Weistr/PV_Holder/Mechinery/chihai-chw-gw4632-370-dc-worm-gear-motor-6-v-6-rpm-2.snapshot.17/Chihai CHW-GW4632-370, DC Worm Gear Motor, 6 V, 6 RPM.JPG

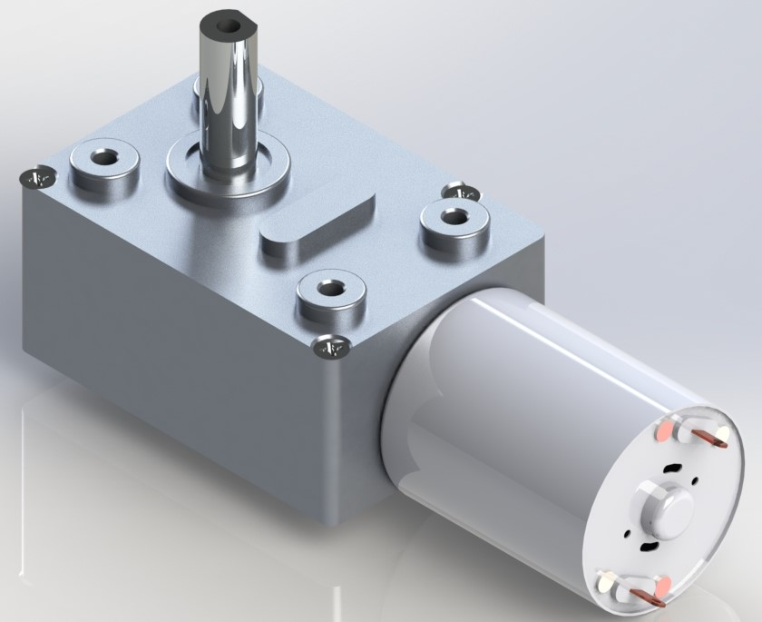
Mechinery/chihai-chw-gw4632-370-dc-worm-gear-motor-6-v-6-rpm-2.snapshot.17/Chihai CHW-GW4632-370, DC Worm Gear Motor, 6 V, 6 RPM.JPG
