Weistr/PV_Holder/Mechinery/chihai-chw-gw4632-370-dc-worm-gear-motor-6-v-6-rpm-2.snapshot.17/DC Motor, Chihai CHW-GW4632-370, DC Worm Gear Motor, 6 V, 6 RPM.SLDASM

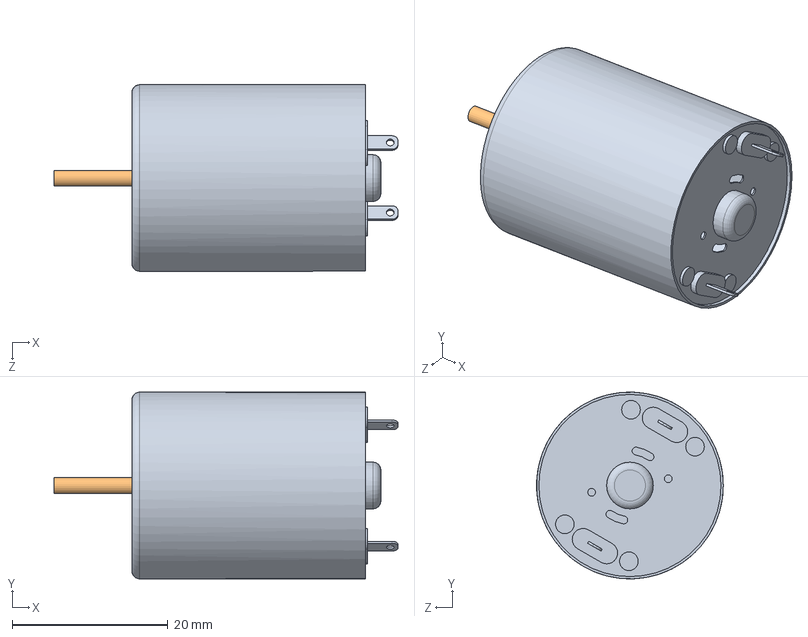
[picture p5: CAD file, 2024-04-27]
Mechinery/chihai-chw-gw4632-370-dc-worm-gear-motor-6-v-6-rpm-2.snapshot.17/DC Motor, Chihai CHW-GW4632-370, DC Worm Gear Motor, 6 V, 6 RPM.SLDASM
44.2 x 24.0 x 24.0 mm
DC Motor Body, Chihai CHW-GW4632-370, DC Worm Gear Motor, 6 V, 6 RPM
DC Motor Shaft, Chihai CHW-GW4632-370, DC Worm Gear Motor, 6 V, 6 RPM
