Weistr/PV_Holder/Mechinery/总装.SLDASM

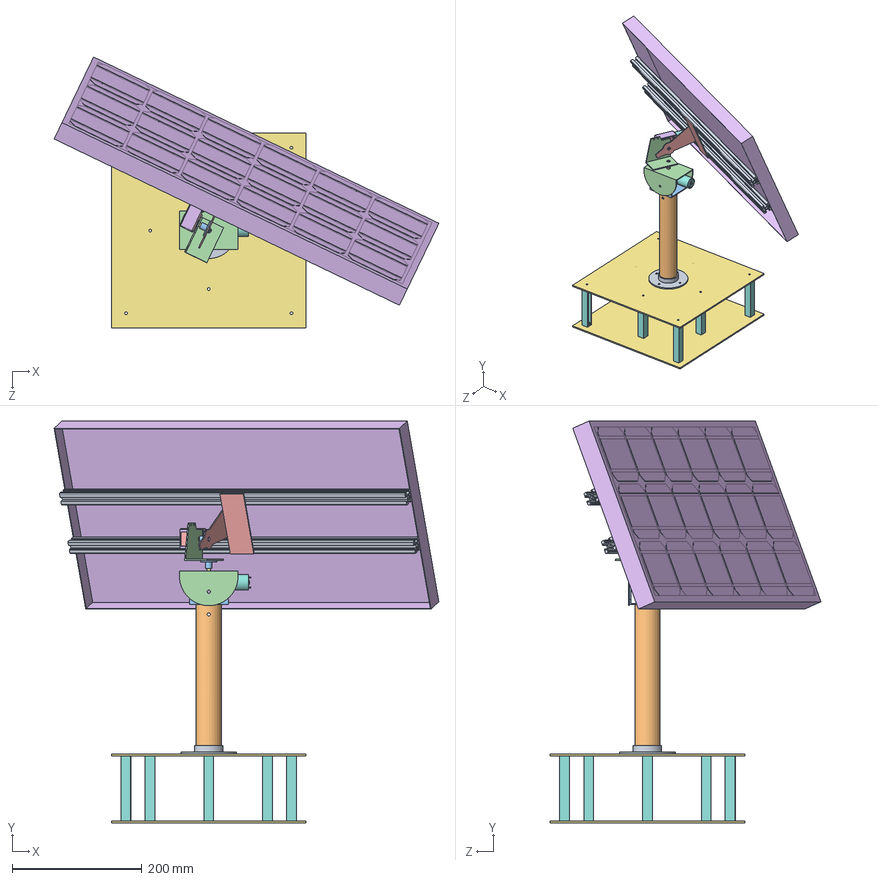
[picture p6: CAD file, 2024-05-19]
Mechinery/总装.SLDASM
592.3 x 618.8 x 417.2 mm
底座
连接柱
U连接1
U连接2
Cover, Chihai CHW-GW4632-370, DC Worm Gear Motor, 6 V, 6 RPM x 2
Gear Body, Chihai CHW-GW4632-370, DC Worm Gear Motor, 6 V, 6 RPM x 2
Shaft, Chihai CHW-GW4632-370, DC Worm Gear Motor, 6 V, 6 RPM x 2
DC Motor Body, Chihai CHW-GW4632-370, DC Worm Gear Motor, 6 V, 6 RPM x 2
DC Motor Shaft, Chihai CHW-GW4632-370, DC Worm Gear Motor, 6 V, 6 RPM x 2
M2 X 6 SS Flat Head Screw, Chihai CHW-GW4632-370, DC Worm Gear Motor, 6 V, 6 RPM x 8
电机联轴 x 2
L连接1
L连接2
Solar PV Panel
底座亚克力板1 x 2
底座支柱2 x 8
铝型材2020R1.5_p1 x 2
