Weistr/PV_Holder/Mechinery/太阳能板/Solar PV Panel.SLDPRT

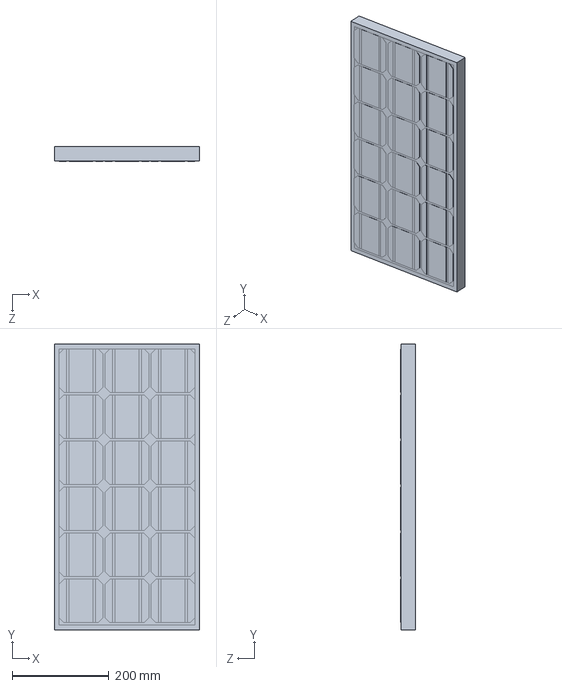
[picture p8: CAD file, 2024-04-27]
Mechinery/太阳能板/Solar PV Panel.SLDPRT
300.0 x 590.0 x 30.5 mm
