Weistr/PV_Holder/Mechinery/总装 - 底座-1.STL

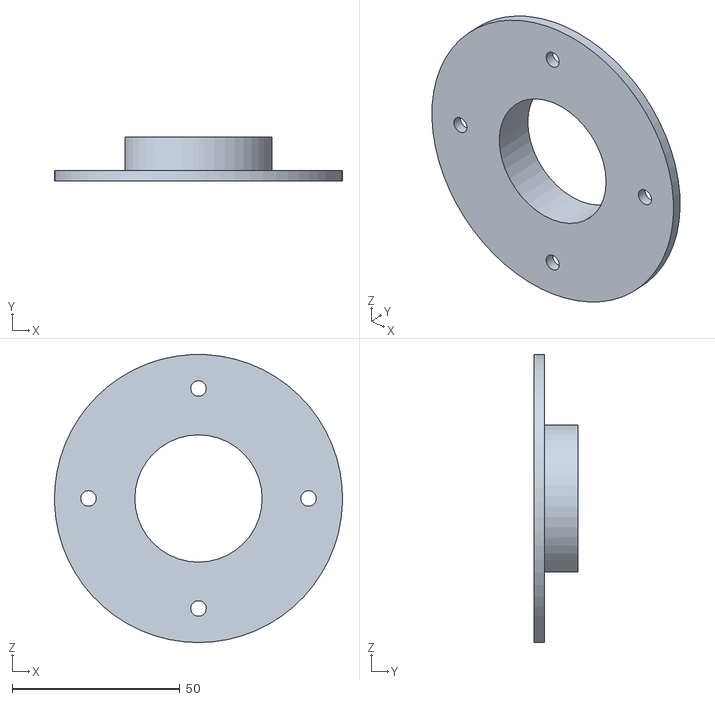
[picture p9: CAD file, 2024-05-19]
Mechinery/总装 - 底座-1.STL
86.0 x 13.0 x 86.0
