Weistr/PV_Holder/Mechinery/chihai-chw-gw4632-370-dc-worm-gear-motor-6-v-6-rpm-2.snapshot.17/Shaft, Chihai CHW-GW4632-370, DC Worm Gear Motor, 6 V, 6 RPM.SLDPRT

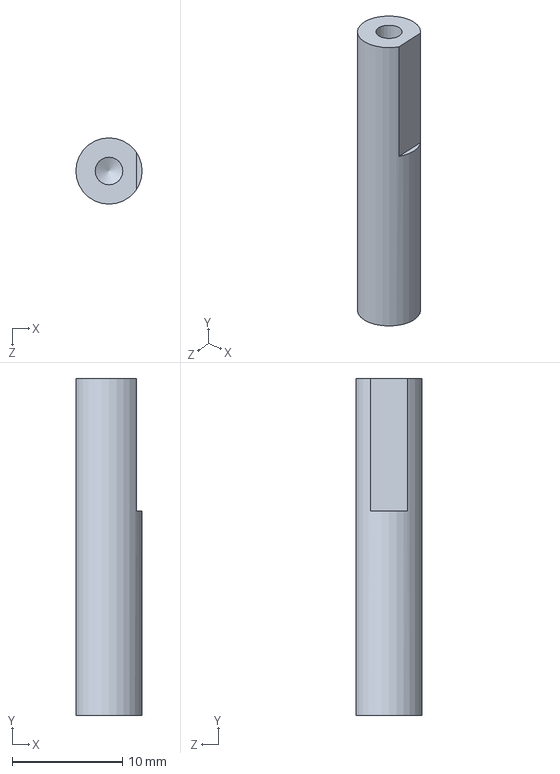
[picture p10: CAD file, 2024-04-27]
Mechinery/chihai-chw-gw4632-370-dc-worm-gear-motor-6-v-6-rpm-2.snapshot.17/Shaft, Chihai CHW-GW4632-370, DC Worm Gear Motor, 6 V, 6 RPM.SLDPRT
6.00 x 30.5 x 6.00 mm
