Weistr/PV_Holder/Mechinery/make/总装.STEP

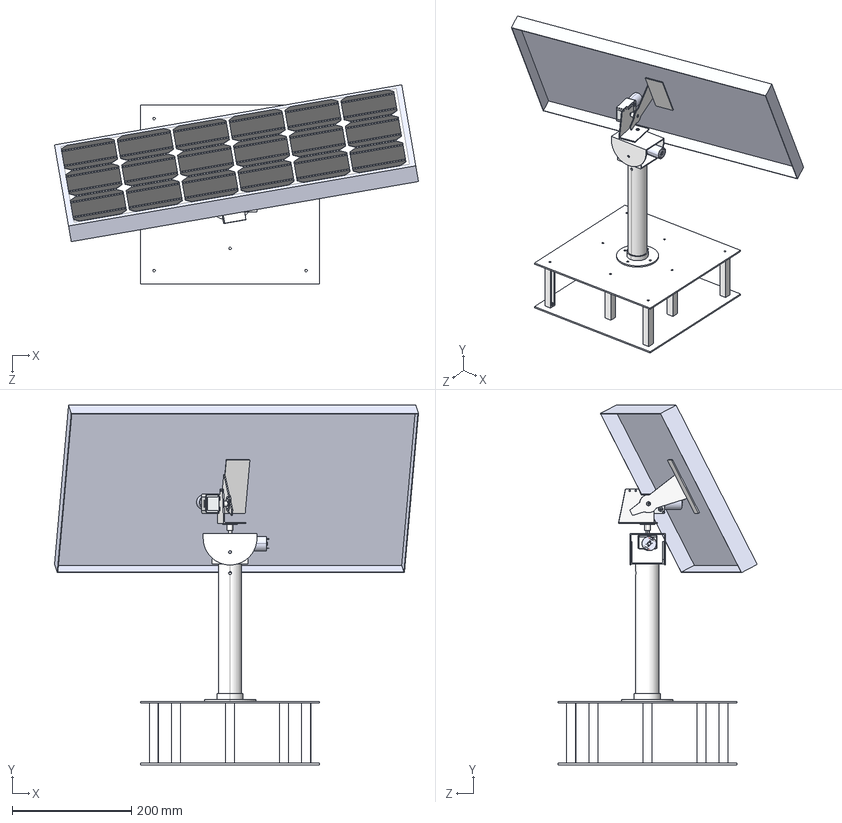
[picture p11: CAD file, 2024-05-19]
Mechinery/make/总装.STEP
609.4 x 601.9 x 333.9 mm
菁釱
蟀諉翐
U蟀諉1
U蟀諉2
Cover, Chihai CHW-GW4632-370, DC Worm Gear Motor, 6 V, 6 RPM x 2
Gear Body, Chihai CHW-GW4632-370, DC Worm Gear Motor, 6 V, 6 RPM x 2
Shaft, Chihai CHW-GW4632-370, DC Worm Gear Motor, 6 V, 6 RPM x 2
DC Motor Body, Chihai CHW-GW4632-370, DC Worm Gear Motor, 6 V, 6 RPM x 2
DC Motor Shaft, Chihai CHW-GW4632-370, DC Worm Gear Motor, 6 V, 6 RPM x 2
M2 X 6 SS Flat Head Screw, Chihai CHW-GW4632-370, DC Worm Gear Motor, 6 V, 6 RPM_default x 8
电机联轴 x 2
L蟀諉1
L蟀諉2
Solar PV Panel
底座亚克力板1 x 2
底座支柱2 x 8
