Weistr/PV_Holder/Mechinery/总装 - 连接柱-1.STL

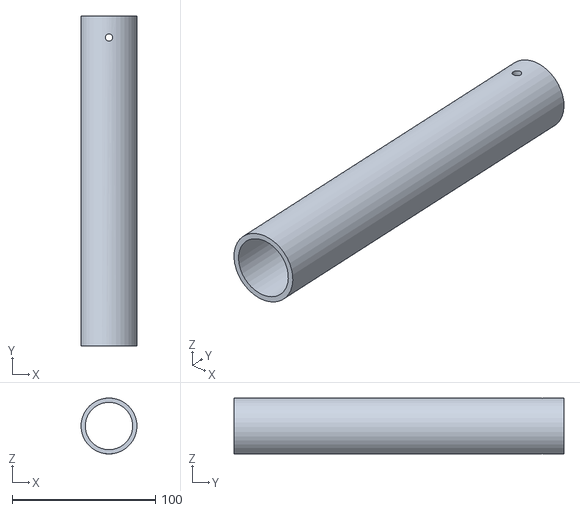
[picture p12: CAD file, 2024-05-19]
Mechinery/总装 - 连接柱-1.STL
39.0 x 230.0 x 39.0
