Weistr/PV_Holder/Mechinery/chihai-chw-gw4632-370-dc-worm-gear-motor-6-v-6-rpm-2.snapshot.17/Chihai CHW-GW4632-370, DC Worm Gear Motor, 6 V, 6 RPM.STEP

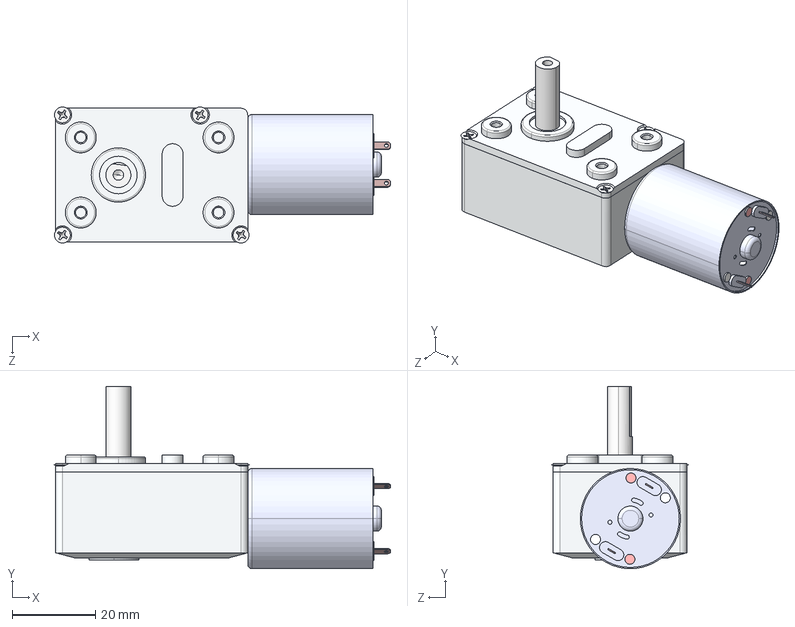
[picture p13: CAD file, 2024-04-27]
Mechinery/chihai-chw-gw4632-370-dc-worm-gear-motor-6-v-6-rpm-2.snapshot.17/Chihai CHW-GW4632-370, DC Worm Gear Motor, 6 V, 6 RPM.STEP
80.5 x 43.7 x 32.6 mm
COVER, CHIHAI CHW-GW4632-370, DC WORM GEAR MOTOR, 6 V, 6 RPM
GEAR BODY, CHIHAI CHW-GW4632-370, DC WORM GEAR MOTOR, 6 V, 6 RPM
SHAFT, CHIHAI CHW-GW4632-370, DC WORM GEAR MOTOR, 6 V, 6 RPM
DC MOTOR BODY, CHIHAI CHW-GW4632-370, DC WORM GEAR MOTOR, 6 V, 6 RPM
DC MOTOR SHAFT, CHIHAI CHW-GW4632-370, DC WORM GEAR MOTOR, 6 V, 6 RPM
M2 X 6 SS FLAT HEAD SCREW, CHIHAI CHW-GW4632-370, DC WORM GEAR MOTOR, 6 V, 6 RPM_default x 4
