Weistr/PV_Holder/Mechinery/总装 - 电机联轴-1.STL

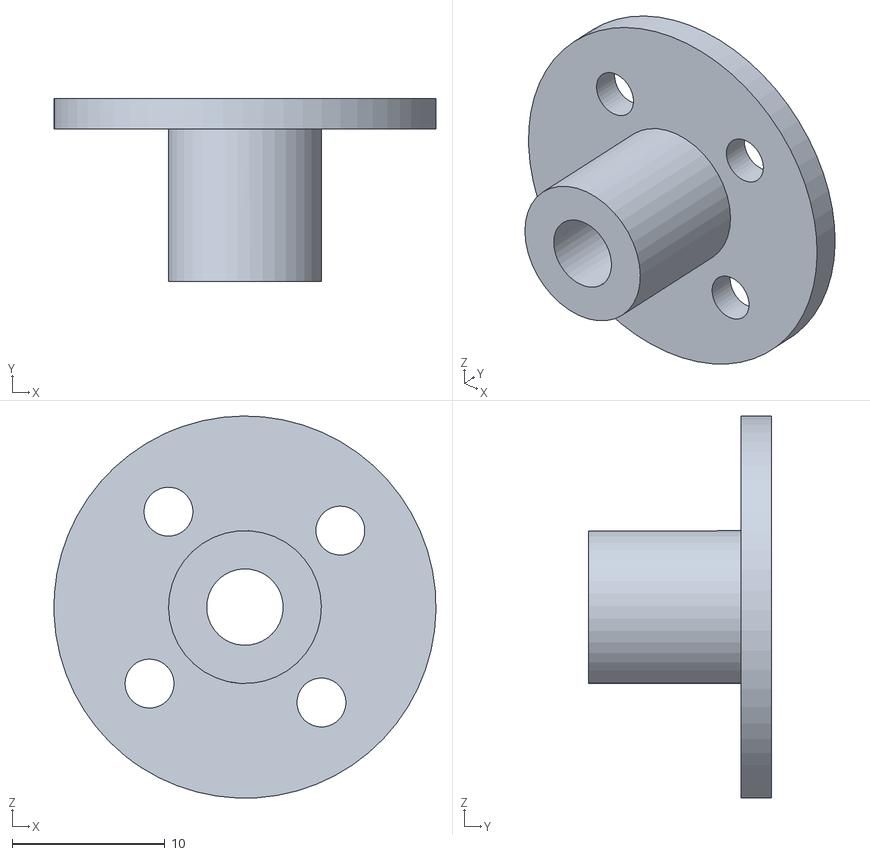
[picture p14: CAD file, 2024-05-19]
Mechinery/总装 - 电机联轴-1.STL
25.0 x 12.0 x 25.0
