Weistr/PV_Holder/Mechinery/总装 - Chihai CHW-GW4632-370, DC Worm Gear Motor, 6 V, 6 RPM-1 Shaft, Chihai CHW-GW4632-370, DC Worm Gear Motor, 6 V, 6 RPM-1.STL

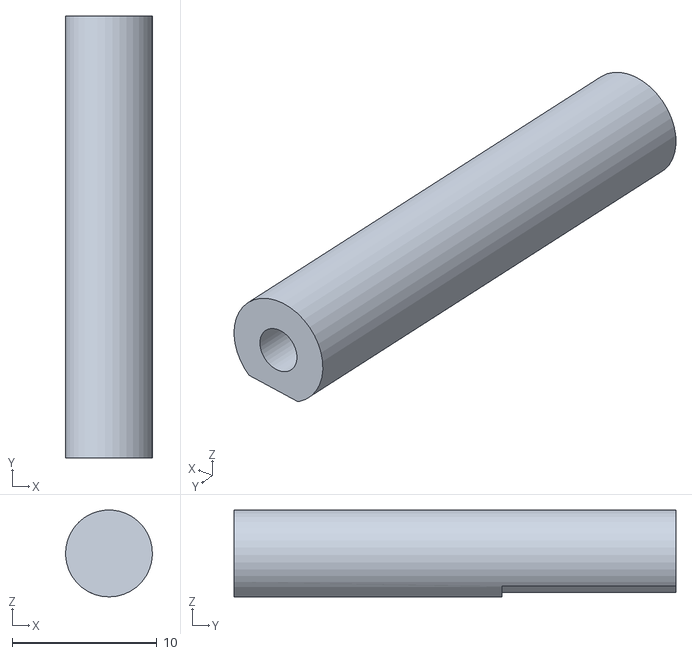
[picture p18: CAD file, 2024-05-19]
Mechinery/总装 - Chihai CHW-GW4632-370, DC Worm Gear Motor, 6 V, 6 RPM-1 Shaft, Chihai CHW-GW4632-370, DC Worm Gear Motor, 6 V, 6 RPM-1.STL
5.99 x 30.5 x 5.99
