Weistr/PV_Holder/Mechinery/chihai-chw-gw4632-370-dc-worm-gear-motor-6-v-6-rpm-2.snapshot.17/DC Motor Shaft, Chihai CHW-GW4632-370, DC Worm Gear Motor, 6 V, 6 RPM.SLDPRT

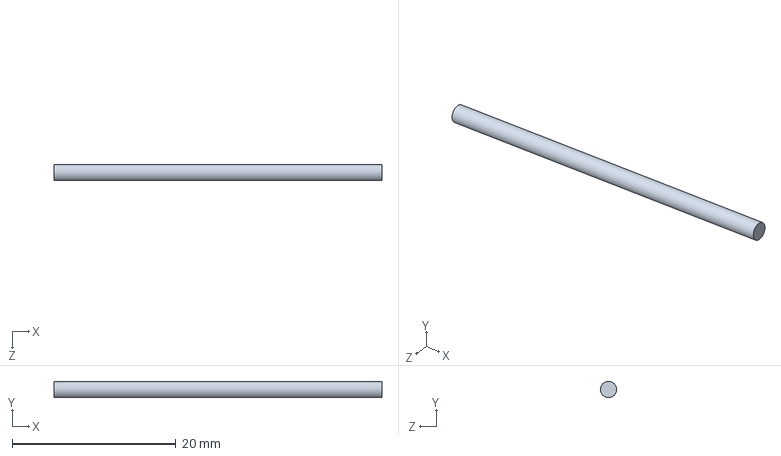
[picture p19: CAD file, 2024-04-27]
Mechinery/chihai-chw-gw4632-370-dc-worm-gear-motor-6-v-6-rpm-2.snapshot.17/DC Motor Shaft, Chihai CHW-GW4632-370, DC Worm Gear Motor, 6 V, 6 RPM.SLDPRT
40.0 x 2.00 x 2.00 mm
