Weistr/PV_Holder/Mechinery/铝型材2020R1.5_p1.SLDPRT

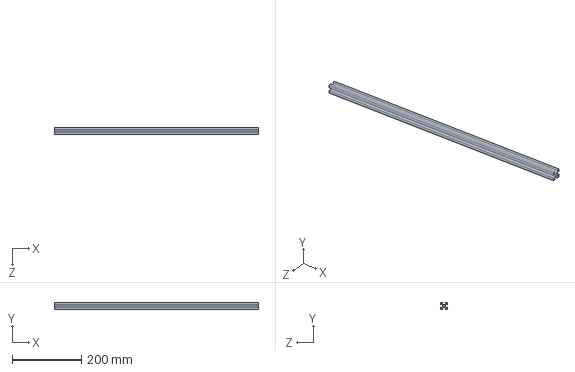
[picture p20: CAD file, 2024-05-19]
Mechinery/铝型材2020R1.5_p1.SLDPRT
590.0 x 20.0 x 20.0 mm
