Weistr/PV_Holder/Mechinery/总装 - L连接1-1.STL

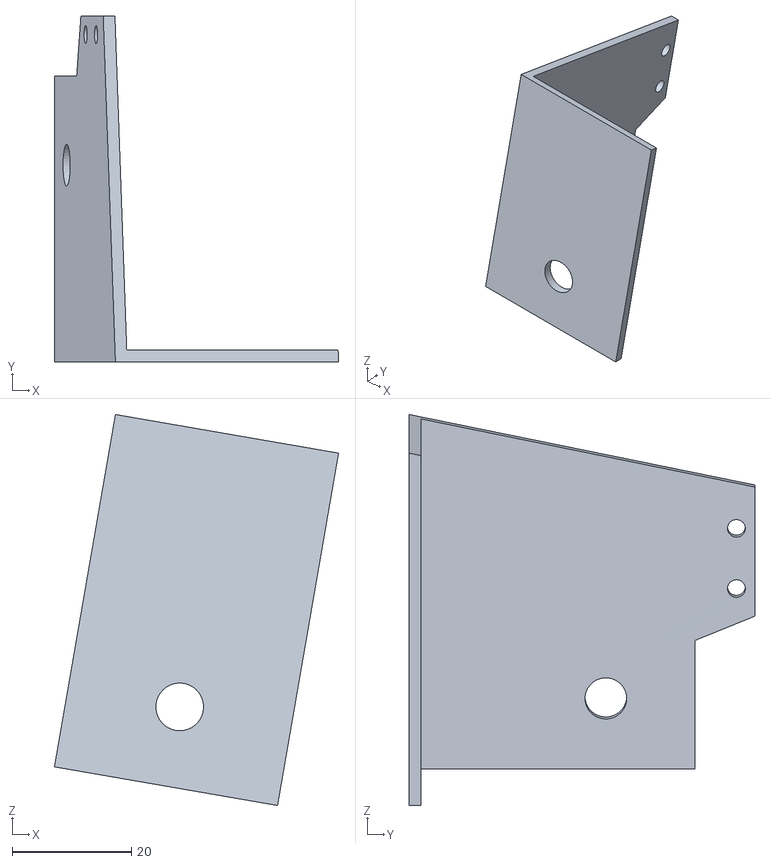
[picture p21: CAD file, 2024-05-19]
Mechinery/总装 - L连接1-1.STL
47.7 x 58.0 x 65.6
