Weistr/PV_Holder/Mechinery/总装 - 底座支柱2-12.STL

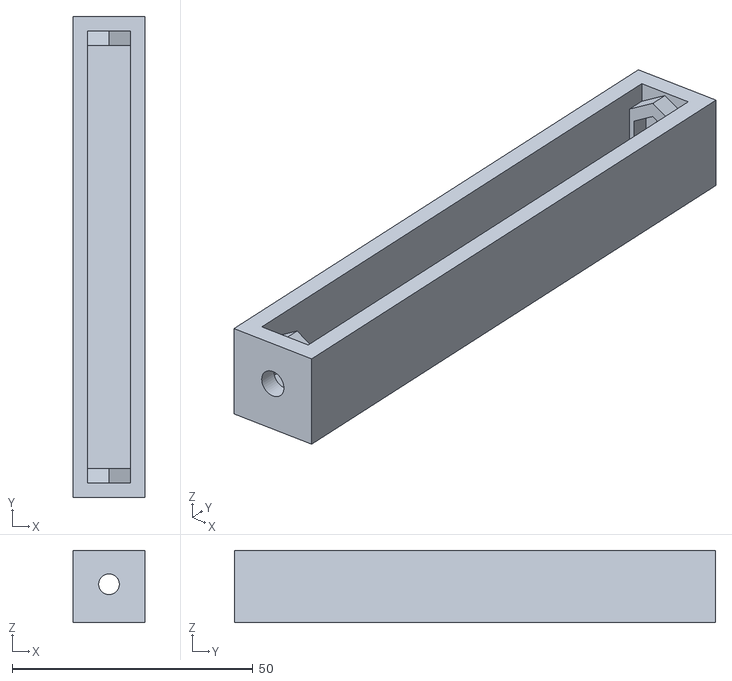
[picture p22: CAD file, 2024-05-19]
Mechinery/总装 - 底座支柱2-12.STL
15.0 x 100.0 x 15.0
