Weistr/PV_Holder/Mechinery/总装 - U连接1-1.STL

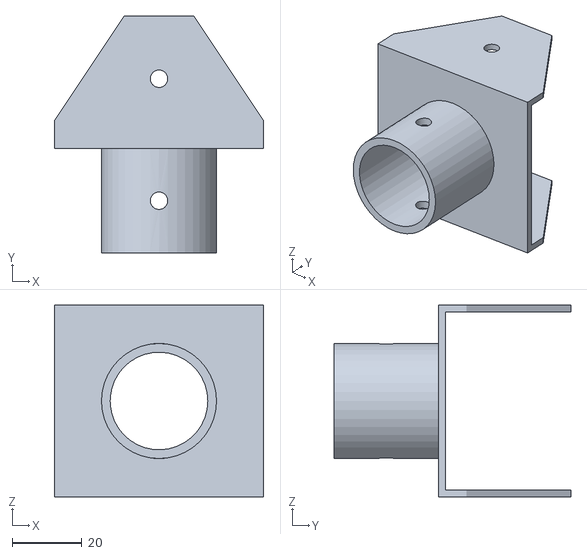
[picture p23: CAD file, 2024-05-19]
Mechinery/总装 - U连接1-1.STL
60.0 x 68.0 x 55.0
