Weistr/PV_Holder/Mechinery/总装 - U连接2-1.STL

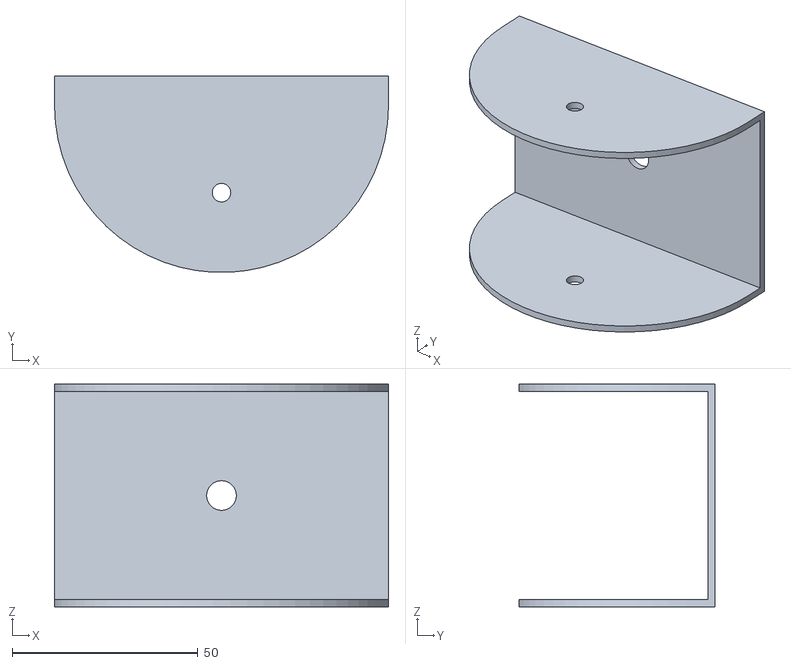
[picture p24: CAD file, 2024-05-19]
Mechinery/总装 - U连接2-1.STL
90.0 x 52.9 x 60.0
