Weistr/PV_Holder/Mechinery/总装 - Chihai CHW-GW4632-370, DC Worm Gear Motor, 6 V, 6 RPM-2 Cover, Chihai CHW-GW4632-370, DC Worm Gear Motor, 6 V, 6 RPM-1.STL

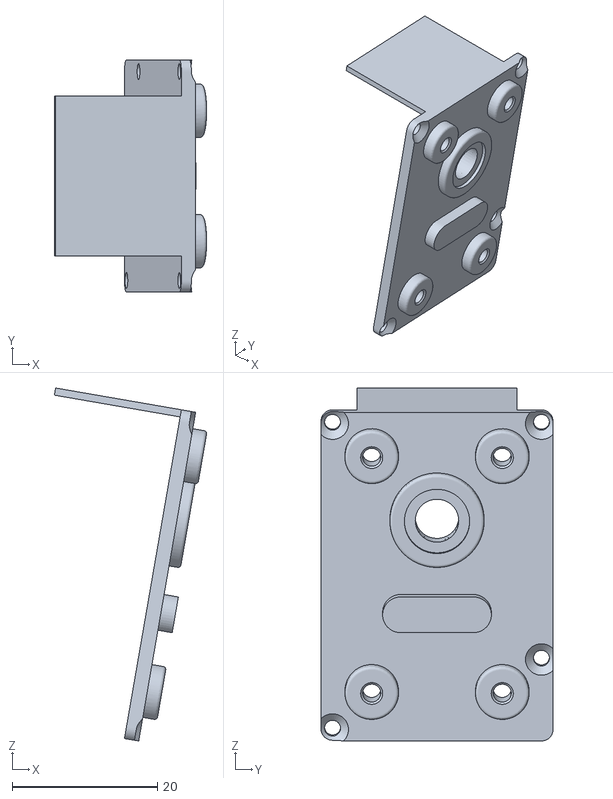
[picture p25: CAD file, 2024-05-19]
Mechinery/总装 - Chihai CHW-GW4632-370, DC Worm Gear Motor, 6 V, 6 RPM-2 Cover, Chihai CHW-GW4632-370, DC Worm Gear Motor, 6 V, 6 RPM-1.STL
21.0 x 32.0 x 48.7
