Weistr/PV_Holder/Mechinery/总装 - Solar PV Panel-1.STL

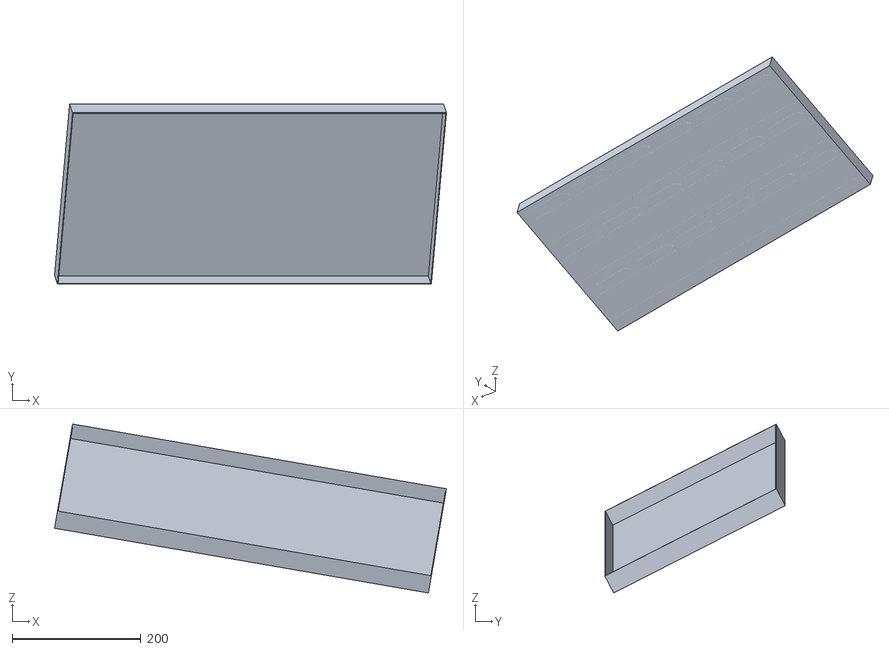
[picture p26: CAD file, 2024-05-19]
Mechinery/总装 - Solar PV Panel-1.STL
609.4 x 280.3 x 262.6
