Weistr/PV_Holder/Mechinery/总装 - L连接2-1.STL

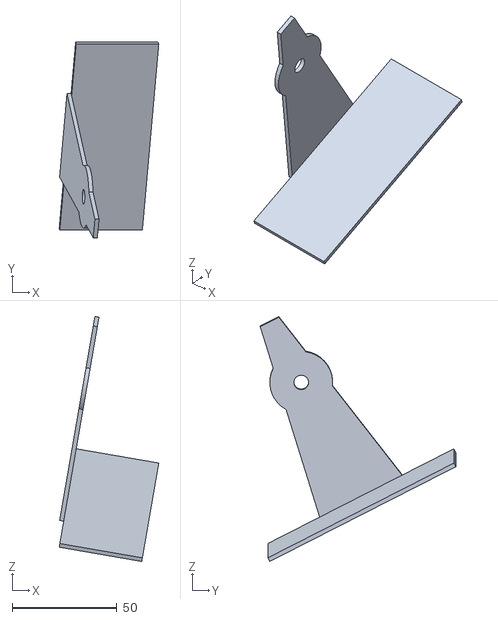
[picture p27: CAD file, 2024-05-19]
Mechinery/总装 - L连接2-1.STL
47.6 x 93.4 x 117.0
