Weistr/PV_Holder/Mechinery/总装 - 底座亚克力板1-1.STL

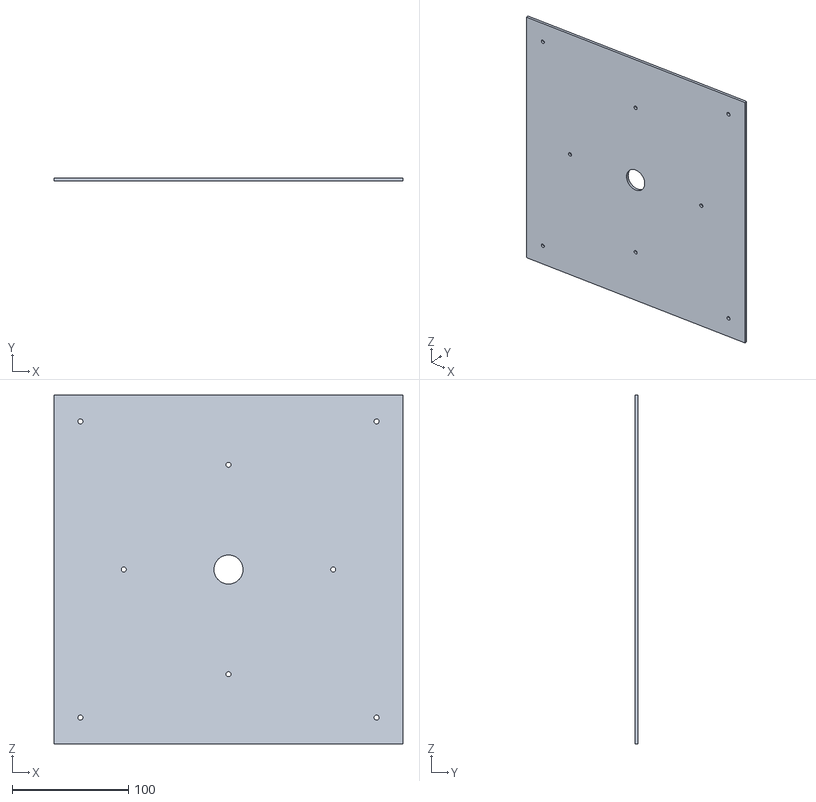
[picture p28: CAD file, 2024-05-19]
Mechinery/总装 - 底座亚克力板1-1.STL
300.0 x 3.00 x 300.0
