Weistr/PV_Holder/Mechinery/总装 - 电机联轴-2.STL

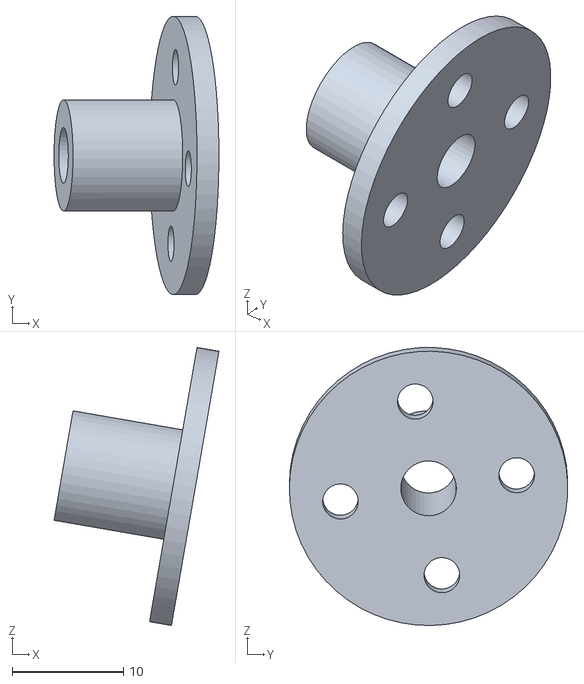
[picture p30: CAD file, 2024-05-19]
Mechinery/总装 - 电机联轴-2.STL
14.8 x 25.0 x 25.0
