Weistr/PV_Holder/Mechinery/底座支柱1.SLDPRT

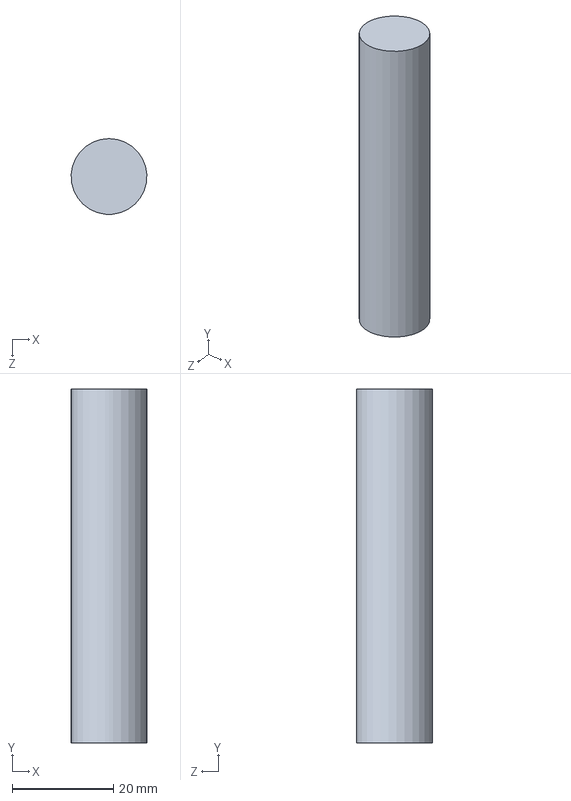
[picture p31: CAD file, 2024-04-27]
Mechinery/底座支柱1.SLDPRT
15.0 x 70.0 x 15.0 mm
