Weistr/PV_Holder/Mechinery/L连接1.SLDPRT

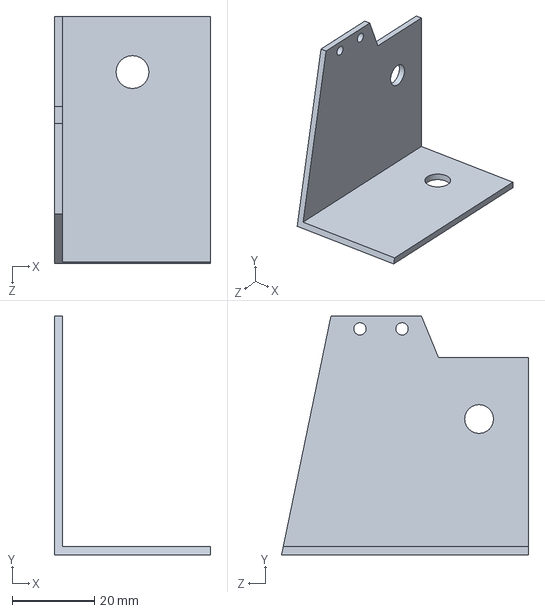
[picture p32: CAD file, 2024-04-27]
Mechinery/L连接1.SLDPRT
38.0 x 58.0 x 60.0 mm
