Weistr/PV_Holder/Mechinery/L连接2.SLDPRT

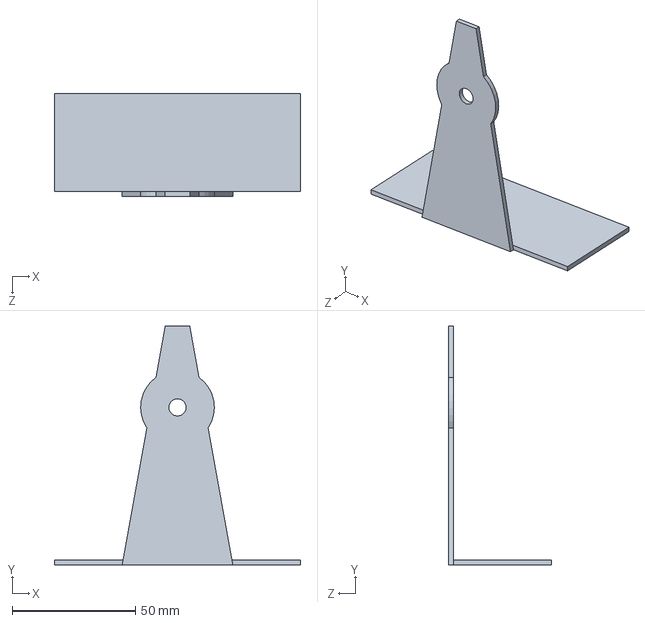
[picture p33: CAD file, 2024-04-27]
Mechinery/L连接2.SLDPRT
100.0 x 97.0 x 42.0 mm
