Weistr/PV_Holder/Mechinery/JGY-370_DC12V1.SLDPRT

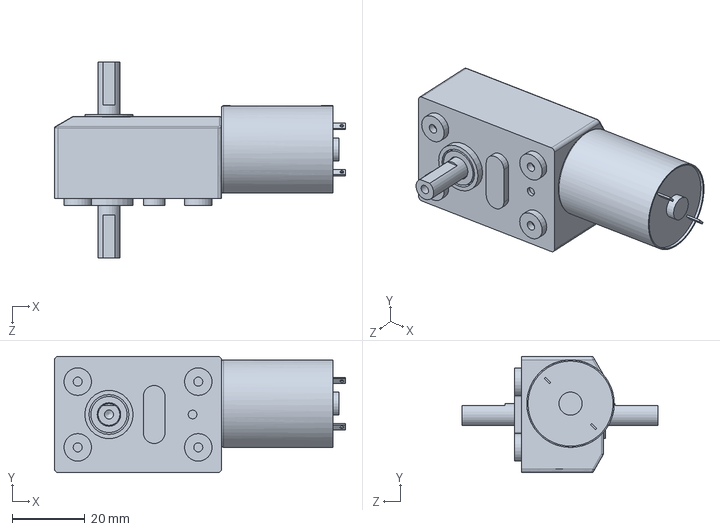
[picture p34: CAD file, 2024-04-27]
Mechinery/JGY-370_DC12V1.SLDPRT
80.2 x 32.0 x 54.1 mm
