Weistr/PV_Holder/(list of files, cad)

Other CAD files:
Mechinery/make/____.STEP.SLDPRT
Mechinery/make/底座亚克力板1.DWG
Mechinery/总装 - 底座支柱2-7.STL
Mechinery/总装 - Chihai CHW-GW4632-370, DC Worm Gear Motor, 6 V, 6 RPM-1 Gear Body, Chihai CHW-GW4632-370, DC Worm Gear Motor, 6 V, 6 RPM-1.STL
Mechinery/总装 - 底座支柱2-6.STL
Mechinery/总装 - 底座支柱2-8.STL
Mechinery/总装 - 底座支柱2-11.STL
Mechinery/总装 - Chihai CHW-GW4632-370, DC Worm Gear Motor, 6 V, 6 RPM-1 Cover, Chihai CHW-GW4632-370, DC Worm Gear Motor, 6 V, 6 RPM-1.STL
Mechinery/总装 - 底座支柱2-5.STL
Mechinery/总装 - 底座亚克力板1-2.STL
Mechinery/总装 - 底座支柱2-9.STL
Mechinery/总装 - 底座支柱2-10.STL
Mechinery/Solar PV Panel.SLDPRT
Mechinery/底座支柱2.SLDPRT
Mechinery/底座亚克力板1.SLDPRT
Mechinery/连接柱.SLDPRT
Mechinery/太阳能板.SLDPRT
Mechinery/U连接1.SLDPRT
Mechinery/电机联轴.SLDPRT
Mechinery/U连接2.SLDPRT
Mechinery/底座.SLDPRT
Mechinery/chihai-chw-gw4632-370-dc-worm-gear-motor-6-v-6-rpm-2.snapshot.17/Chihai CHW-GW4632-370, DC Worm Gear Motor, 6 V, 6 RPM.SLDASM
Mechinery/chihai-chw-gw4632-370-dc-worm-gear-motor-6-v-6-rpm-2.snapshot.17/Chihai CHW-GW4632-370, DC Worm Gear Motor, 6 V, 6 RPM.x_b
Mechinery/chihai-chw-gw4632-370-dc-worm-gear-motor-6-v-6-rpm-2.snapshot.17/M2 X 6 SS Flat Head Screw, Chihai CHW-GW4632-370, DC Worm Gear Motor, 6 V, 6 RPM.SLDPRT
Mechinery/总装 - Chihai CHW-GW4632-370, DC Worm Gear Motor, 6 V, 6 RPM-1 M2 X 6 SS Flat Head Screw, Chihai CHW-GW4632-370, DC Worm Gear Motor, 6 V, 6 RPM-1.STL
Mechinery/总装 - Chihai CHW-GW4632-370, DC Worm Gear Motor, 6 V, 6 RPM-1 M2 X 6 SS Flat Head Screw, Chihai CHW-GW4632-370, DC Worm Gear Motor, 6 V, 6 RPM-2.STL
Mechinery/总装 - Chihai CHW-GW4632-370, DC Worm Gear Motor, 6 V, 6 RPM-1 M2 X 6 SS Flat Head Screw, Chihai CHW-GW4632-370, DC Worm Gear Motor, 6 V, 6 RPM-3.STL
Mechinery/总装 - Chihai CHW-GW4632-370, DC Worm Gear Motor, 6 V, 6 RPM-1 M2 X 6 SS Flat Head Screw, Chihai CHW-GW4632-370, DC Worm Gear Motor, 6 V, 6 RPM-4.STL
Mechinery/总装 - Chihai CHW-GW4632-370, DC Worm Gear Motor, 6 V, 6 RPM-2 M2 X 6 SS Flat Head Screw, Chihai CHW-GW4632-370, DC Worm Gear Motor, 6 V, 6 RPM-1.STL
Mechinery/总装 - Chihai CHW-GW4632-370, DC Worm Gear Motor, 6 V, 6 RPM-2 M2 X 6 SS Flat Head Screw, Chihai CHW-GW4632-370, DC Worm Gear Motor, 6 V, 6 RPM-2.STL
Mechinery/总装 - Chihai CHW-GW4632-370, DC Worm Gear Motor, 6 V, 6 RPM-2 M2 X 6 SS Flat Head Screw, Chihai CHW-GW4632-370, DC Worm Gear Motor, 6 V, 6 RPM-3.STL
Mechinery/总装 - Chihai CHW-GW4632-370, DC Worm Gear Motor, 6 V, 6 RPM-2 M2 X 6 SS Flat Head Screw, Chihai CHW-GW4632-370, DC Worm Gear Motor, 6 V, 6 RPM-4.STL
