Weistr/PV_Holder/Electrical/SCH_Schematic1_2024-05-14.pdf

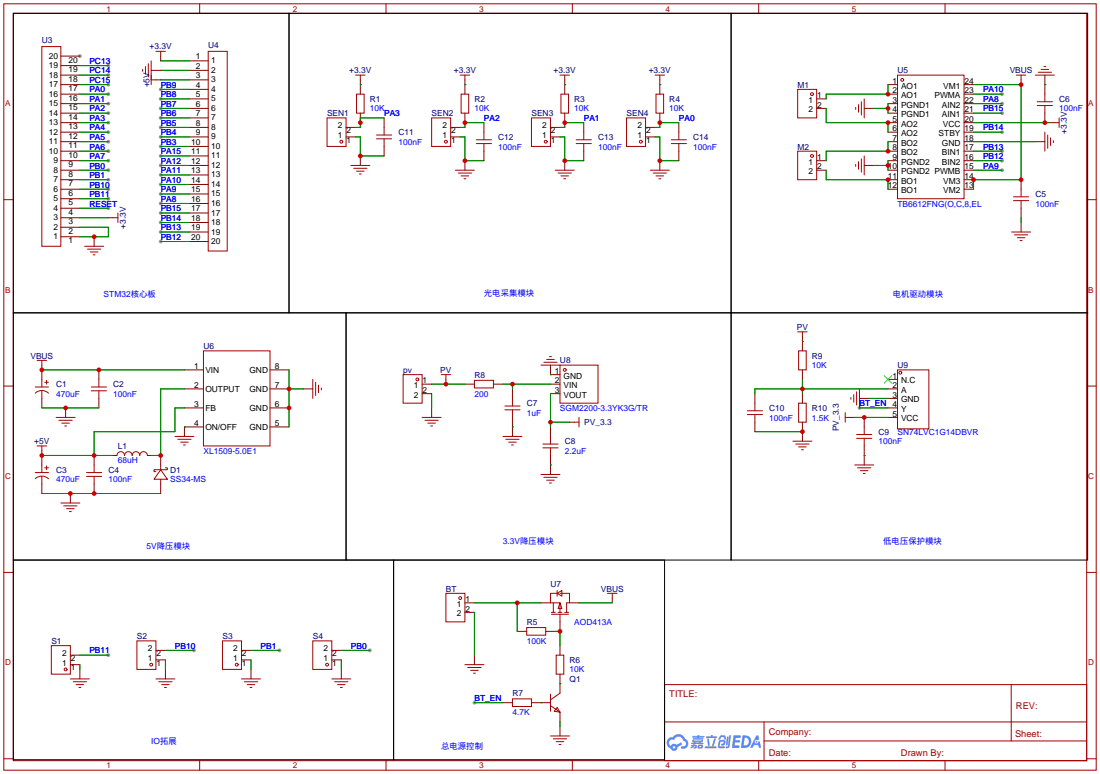
[picture p35: page 1]
