Weistr/PV_Holder/(list of files, drawings)

Other design files:
Electrical/solorTraker.eprj
Electrical/核心板/ProProject_stm32f103c8t6最小系统板_2024-05-02.epro
Electrical/核心板/stm32f103c8t6最小系统板.eprj
