Weistr/PV_Holder/Firmware/Core/Src/main.c

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
/* Includes ------------------------------------------------------------------*/
#include "main.h"
#include "adc.h"
#include "dma.h"
#include "tim.h"
#include "gpio.h"

/* USER CODE BEGIN Includes */
#include "pid.h"
/* USER CODE END Includes */

/* USER CODE BEGIN PTD */
uint16_t sen_raw[4];//光敏电阻ADC采样的数值放在该数组里
/* USER CODE END PTD */

/* USER CODE BEGIN PD */
#define AIN1_set() HAL_GPIO_WritePin(AIN1_GPIO_Port,AIN1_Pin,GPIO_PIN_SET) 
#define AIN2_set() HAL_GPIO_WritePin(AIN2_GPIO_Port,AIN2_Pin,GPIO_PIN_SET) 
#define BIN1_set() HAL_GPIO_WritePin(BIN1_GPIO_Port,BIN1_Pin,GPIO_PIN_SET) 
#define BIN2_set() HAL_GPIO_WritePin(BIN1_GPIO_Port,BIN2_Pin,GPIO_PIN_SET) 
#define AIN1_clr() HAL_GPIO_WritePin(AIN1_GPIO_Port,AIN1_Pin,GPIO_PIN_RESET) 
#define AIN2_clr() HAL_GPIO_WritePin(AIN2_GPIO_Port,AIN2_Pin,GPIO_PIN_RESET) 
#define BIN1_clr() HAL_GPIO_WritePin(BIN1_GPIO_Port,BIN1_Pin,GPIO_PIN_RESET) 
#define BIN2_clr() HAL_GPIO_WritePin(BIN1_GPIO_Port,BIN2_Pin,GPIO_PIN_RESET) 


#define TimerMaxCount 1000
/* USER CODE END PD */


void SystemClock_Config(void);
/* USER CODE BEGIN 0 */
//========================================================================
// 函数: 
// 描述: 电机控制函数
// 参数: None.
// 返回: None.
//========================================================================
void motor_ctl(int16_t spd,uint8_t motorid)
{
  if (spd > TimerMaxCount) //限制最大速度
  {
    spd = TimerMaxCount;
  }
  
  switch (motorid)//选择哪个电机动作
  {
  case 0://俯仰电机
    if (spd < 0)
    {
      AIN1_set();//电机正转
      AIN2_clr();
    }
    else
    {
      AIN1_clr();//电机反转
      AIN2_set();
    }
    __HAL_TIM_SetCompare(&htim1,TIM_CHANNEL_2,spd);//设置电机PWM占空比
    break;
  case 1://方向电机
    if (spd < 0)
    {
      BIN1_set();//电机正转
      BIN2_clr();
    }
    else
    {
      BIN1_clr();//电机反转
      BIN2_set();
    }
    __HAL_TIM_SetCompare(&htim1,TIM_CHANNEL_3,spd);//设置电机PWM占空比
    break; 
  default:
    break;
  }
}
/* USER CODE END 0 */

/**
  * @brief  The application entry point.
  * @retval int
  */
int main(void)
{
  /* MCU Configuration--------------------------------------------------------*/

  /* Reset of all peripherals, Initializes the Flash interface and the Systick. */
  HAL_Init();

  /* Configure the system clock */
  SystemClock_Config();

  /* Initialize all configured peripherals */
  MX_GPIO_Init();
  MX_DMA_Init();
  MX_ADC1_Init();
  MX_TIM1_Init();
  /* USER CODE BEGIN 2 */
  //启动ADC校准
  HAL_ADCEx_Calibration_Start(&hadc1);
  //设置PWM和定时器
	__HAL_TIM_SetAutoreload(&htim1,TimerMaxCount);
	__HAL_TIM_PRESCALER(&htim1,7);

	__HAL_TIM_SetCompare(&htim1,TIM_CHANNEL_2,0);
	__HAL_TIM_SetCompare(&htim1,TIM_CHANNEL_3,0);


	HAL_TIM_PWM_Start(&htim1,TIM_CHANNEL_2);
	HAL_TIM_PWM_Start(&htim1,TIM_CHANNEL_3);

  //初始化PID参数
  pid_param_Init();
  /* USER CODE END 2 */

  /* Infinite loop */
  /* USER CODE BEGIN WHILE */
  while (1)
  {
    /* USER CODE END WHILE */
    HAL_ADC_Start_DMA(&hadc1,sen_raw,4);//启动ADC转换
    HAL_ADC_PollForConversion(&hadc1, 20);//等待ADC转换完成，最多等20ms

    pitMotorPidSt.measured = sen_raw[0] - sen_raw[1];
    pitMotorPidSt.desired = 0;
    yawMotorPidSt.measured = sen_raw[1] - sen_raw[2];
    yawMotorPidSt.desired = 0;

    pidUpdate(&pitMotorPidSt,0.01);
    pidUpdate(&yawMotorPidSt,0.01);

    motor_ctl(pitMotorPidSt.out,0);
    motor_ctl(yawMotorPidSt.out,0);

    /* USER CODE BEGIN 3 */

  }
  /* USER CODE END 3 */
}

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
