Weistr/PV_Holder/Firmware/firmware.ioc

Mcu.UserName=STM32F103C8Tx
PA0-WKUP.Signal=ADCx_IN0
PA1.Signal=ADCx_IN1
PA10.Signal=S_TIM1_CH3
PA13.Signal=SYS_JTMS-SWDIO
PA14.Signal=SYS_JTCK-SWCLK
PA2.Signal=ADCx_IN2
PA3.Signal=ADCx_IN3
PA8.GPIO_Label=AIN2
PA8.Signal=GPIO_Output
PA9.Signal=S_TIM1_CH2
PB12.GPIO_Label=BIN2
PB12.Signal=GPIO_Output
PB13.GPIO_Label=BIN1
PB13.Signal=GPIO_Output
PB14.GPIO_Label=STBY
PB14.Signal=GPIO_Output
PB15.GPIO_Label=AIN1
PB15.Signal=GPIO_Output
PD0-OSC_IN.Signal=RCC_OSC_IN
PD1-OSC_OUT.Signal=RCC_OSC_OUT
