Weistr/PV_Holder/Firmware/Core/Inc/main.h

#define BIN2_Pin GPIO_PIN_12
#define BIN2_GPIO_Port GPIOB
#define BIN1_Pin GPIO_PIN_13
#define BIN1_GPIO_Port GPIOB
#define STBY_Pin GPIO_PIN_14
#define STBY_GPIO_Port GPIOB
#define AIN1_Pin GPIO_PIN_15
#define AIN1_GPIO_Port GPIOB
#define AIN2_Pin GPIO_PIN_8
#define AIN2_GPIO_Port GPIOA
