Weistr/PV_Holder/(commit log)

2024-03-11 添加了主控和电机相关内容
2024-03-13 更新底座设计
    [底座.SLDPRT]
2024-03-13 代码和机械零件
    [cmsis-dap.cfg, stlink.cfg, stm32f1x.cfg, 总装.SLDASM, 连接柱.SLDPRT]
2024-04-17 目录，系统介绍和硬件设计
2024-04-19 更新了硬件部分
2024-04-27 更新了结构
    [Chihai CHW-GW4632-370, DC Worm Gear Motor, 6 V, 6 RPM.SLDASM, Chihai CHW-GW4632-370, DC Worm Gear Motor, 6 V, 6 RPM.STEP, Chihai CHW-GW4632-370, DC Worm Gear Motor, 6 V, 6 RPM.x_b, Cover, Chihai CHW-GW4632-370, DC Worm Gear Motor, 6 V, 6 RPM.SLDPRT, DC Motor Body, Chihai CHW-GW4632-370, DC Worm Gear Motor, 6 V, 6 RPM.SLDPRT, DC Motor Shaft, Chihai CHW-GW4632-370, DC Worm Gear Motor, 6 V, 6 RPM.SL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]
2024-05-02 更新了亚克力板，支撑
    [Solar PV Panel.SLDPRT, 底座亚克力板1.SLDPRT, 底座支柱2.SLDPRT, 总装.SLDASM, 铝型材2020R1.5_p1.SLDPRT]
2024-05-02 更新了电路和程序
    [ProProject_stm32f103c8t6最小系统板_2024-05-02.epro, cmsis-dap.cfg, solorTraker.eprj, stlink.cfg, stm32f103c8t6最小系统板.eprj, stm32f1x.cfg]
2024-05-19 更新了代码
    [____.STEP.SLDPRT, solorTraker.eprj, 底座亚克力板1.DWG, 总装 - Chihai CHW-GW4632-370, DC Worm Gear Motor, 6 V, 6 RPM-1 Cover, Chihai CHW-GW4632-370, DC Worm Gear Motor, 6 V, 6 RPM-1.STL, 总装 - Chihai CHW-GW4632-370, DC Worm Gear Motor, 6 V, 6 RPM-1 Gear Body, Chihai CHW-GW4632-370, DC Worm Gear Motor, 6 V, 6 RPM-1.STL, 总装 - Chihai CHW-GW4632-370, DC Worm Gear Motor, 6 V, 6 RPM-1 M2 X 6 SS Flat Head Screw, 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]
